jritzl/EE313project/ltspiceCompleteCircuit.asc

C1: cap; 10µ
C2: cap; 47µ
C3: cap; 47µ
C4: cap; 47µ
C5: cap
C7: cap
C: cap; 1nF
D1: diode; 1N4148
D2: diode; 1N4148
D4: LED
I2: current; SINE(0 100nA 1K)
InputSignal: signal; ""
InputSignal: signal; ""
M1: pmos
M2: pmos
M3: pmos
M4: nmos
M5: nmos
M6: nmos
Q1: npn; BC108
Q2: npn; BC108
Q3: npn; BC108
R1: res; 1k
R2: res; 50k
R3: res; 15k
R4: res; 270k
R5: res; 1Meg
R6: res; 6.8k
R7: res; 1k
R8: res; 10k
R9: res; 680
R10: res; 1k
R11: res
R12: res
R13: res; 100k
R15: res
R16: res
R17: res
R18: res
R: res; 33kohm
U1: opamp2; UA741
U2: opamp2; UA741
U3: opamp
U4: opamp
U5: opamp
U6: opamp
U7: opamp
V1: signal; 12
V3: signal; -12
Named nets: 0, +Vcc, -Vcc, InputSignal, MicSignal, Vout, Pin, BufferedInput, Output, V1, V2, V3, V4, RedPin, GreenPin, BluePin, A, B, C
.inc UA741.lib
.inc 1N4148.lib
Amplifier
Buffer
Output of the AGC
goes to transmitter
This node goes
back to the input 
of the AGC circuit
Ebrar Çakmak 2442721
Yunus Emre Tüysüz 2444032
Transmission
with LED
Receiver with Photodiode
and Transresistor Amplifier
High Pass Filter
Low Pass Filter
GATE
Gate Circuit with MOSFETs
Comparator Circuit for Single RGB LED
